grldkln/WCR/WRC Iso Image.jpg

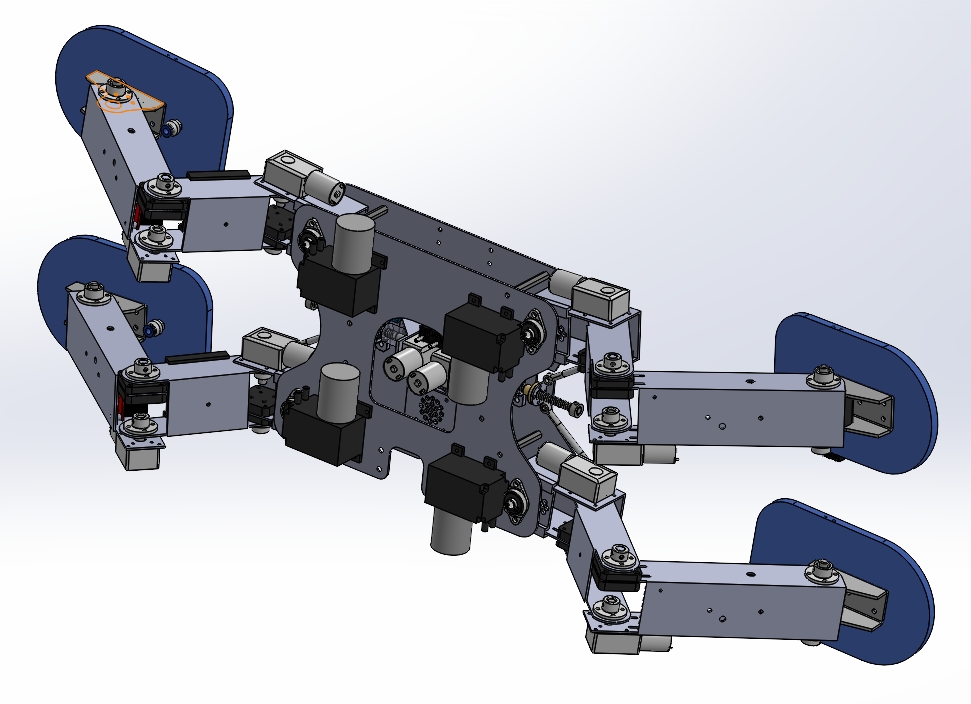
WRC Iso Image.jpg
