grldkln/WCR/WRC Front View.jpg

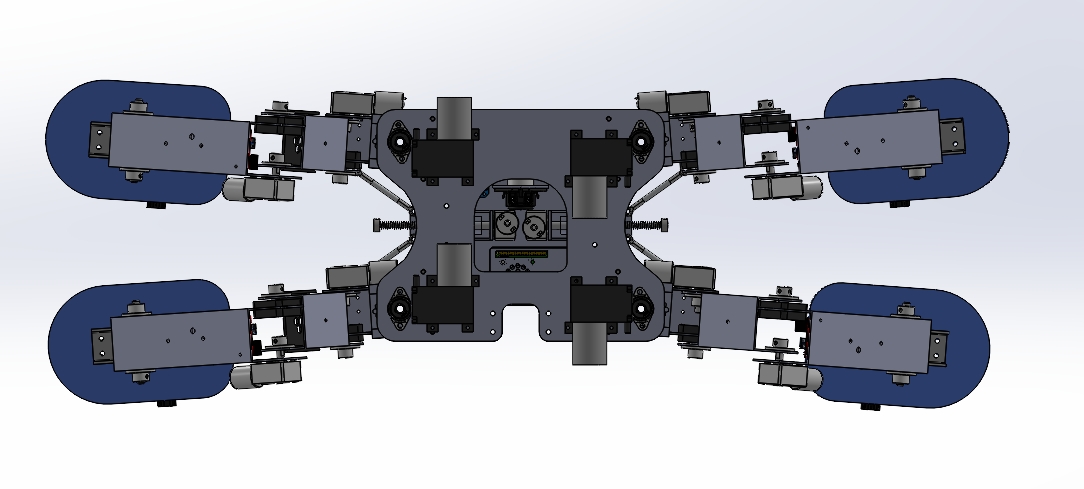
WRC Front View.jpg
