grldkln/WCR/README.md

Please note that this repository is used only as a showcase for my final thesis project.
All of the designs are made by myself, with some code dependencies.
This project is not meant to be developed further, but can be used as a reference or as an example.
