grldkln/WCR/RP4 Mount.jpg

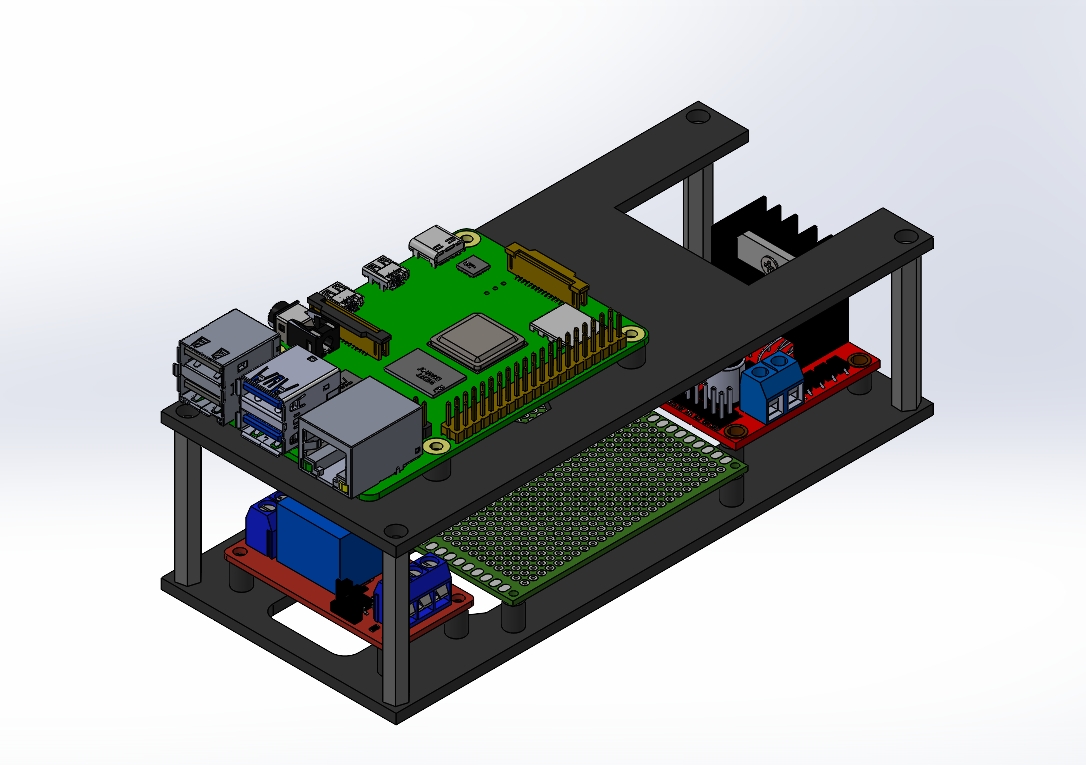
RP4 Mount.jpg
