grldkln/WCR/Controller_Board/Limb Controller Schematic ver 0.1.pdf

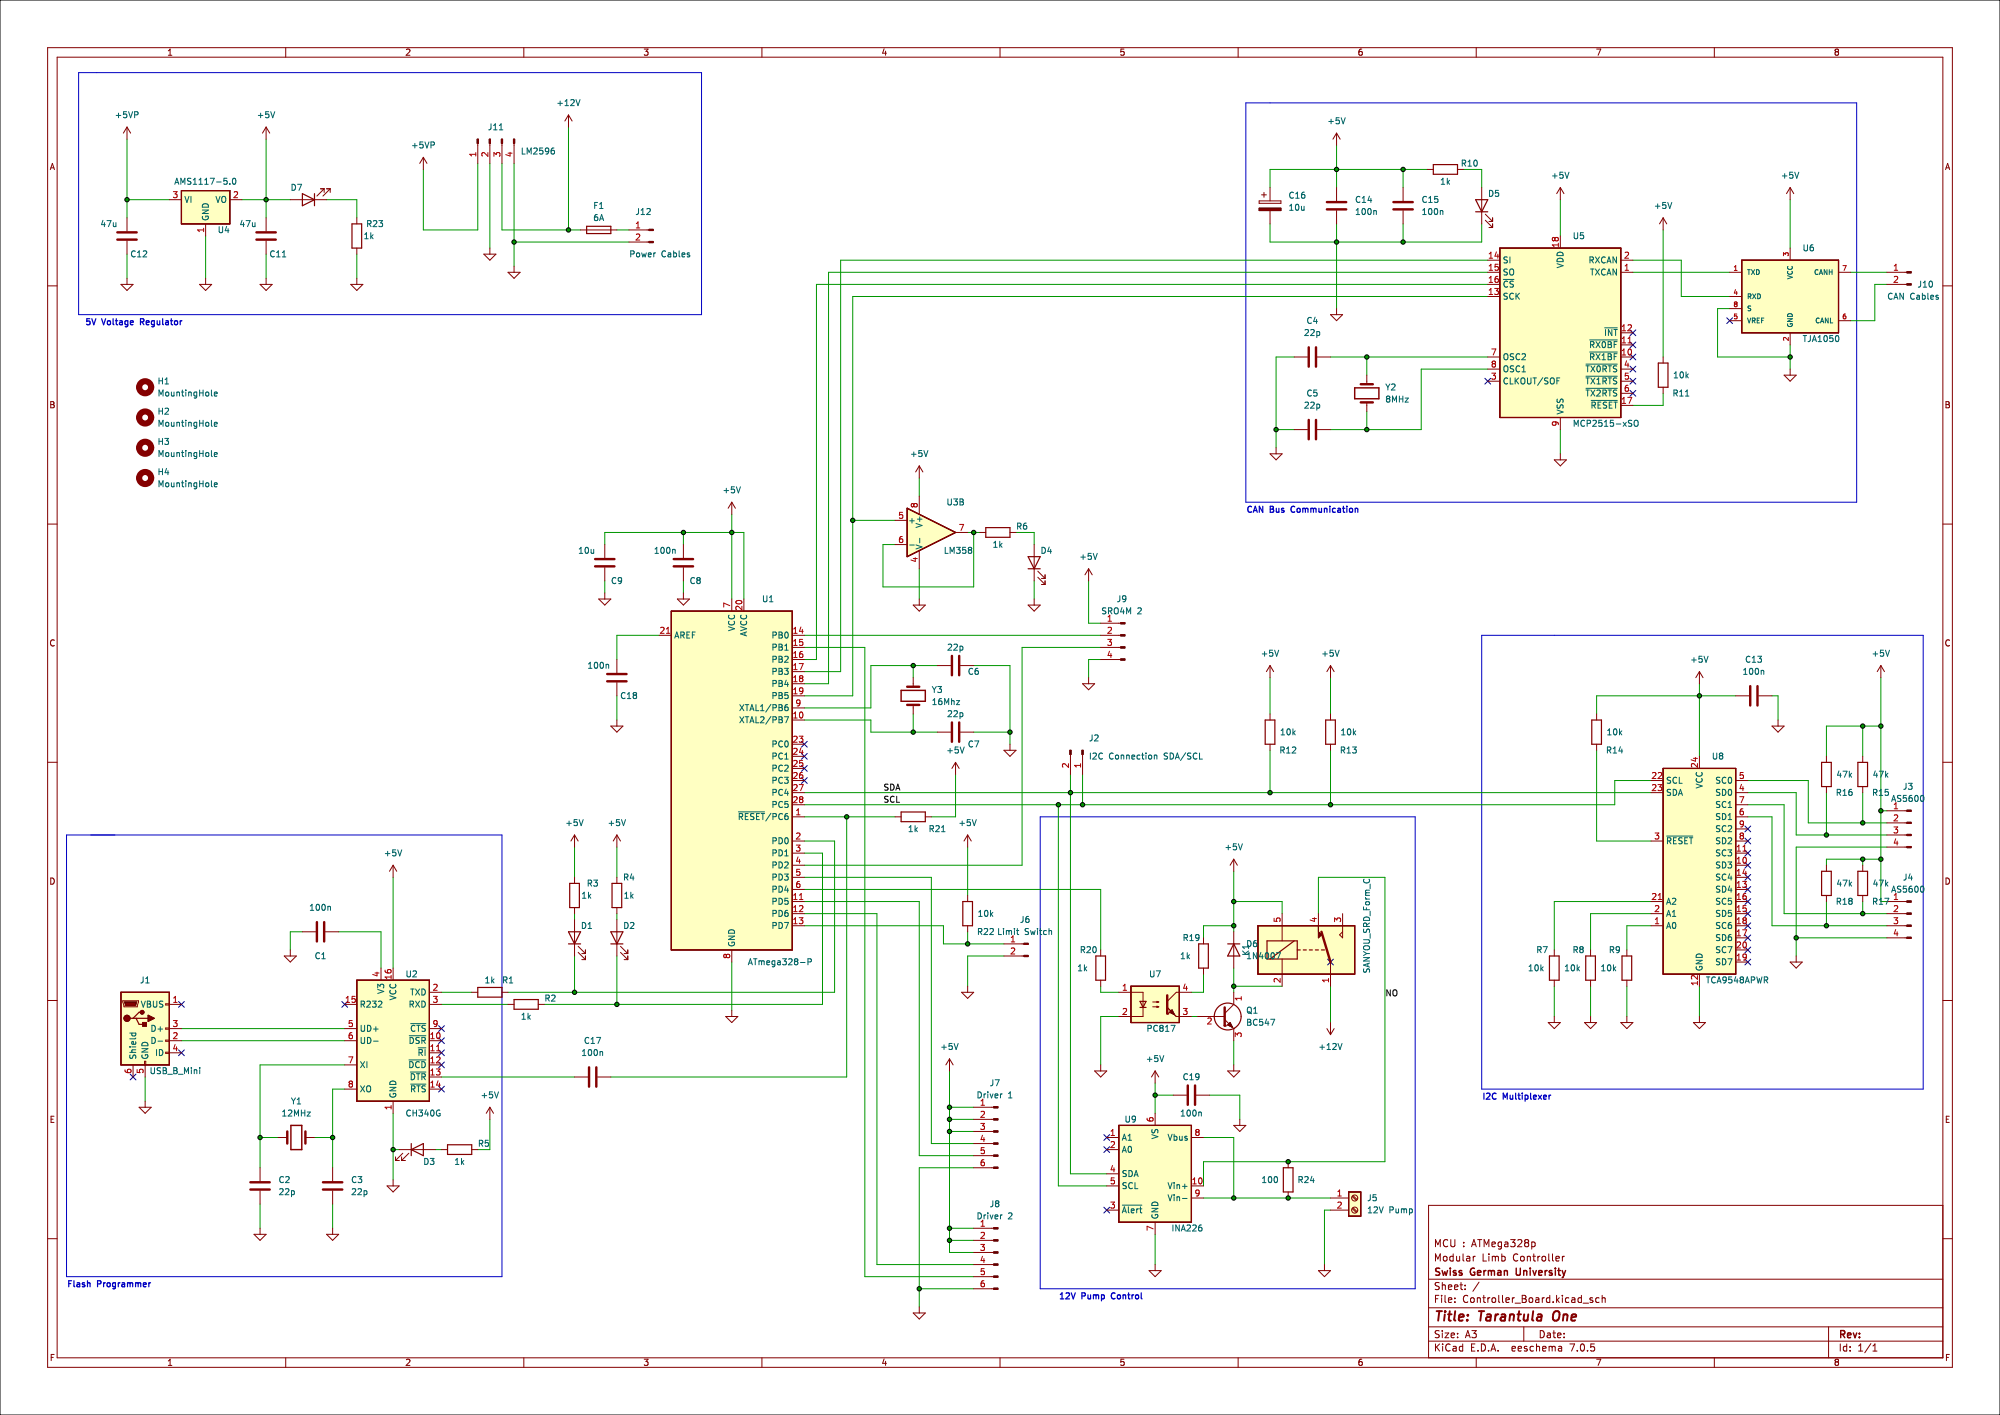
[picture p63: page 1]
