grldkln/WCR/Controller_Board/Controller_Board.kicad_pcb

## KiCad design Controller_Board/Controller_Board.kicad_pcb (2025-01-19)

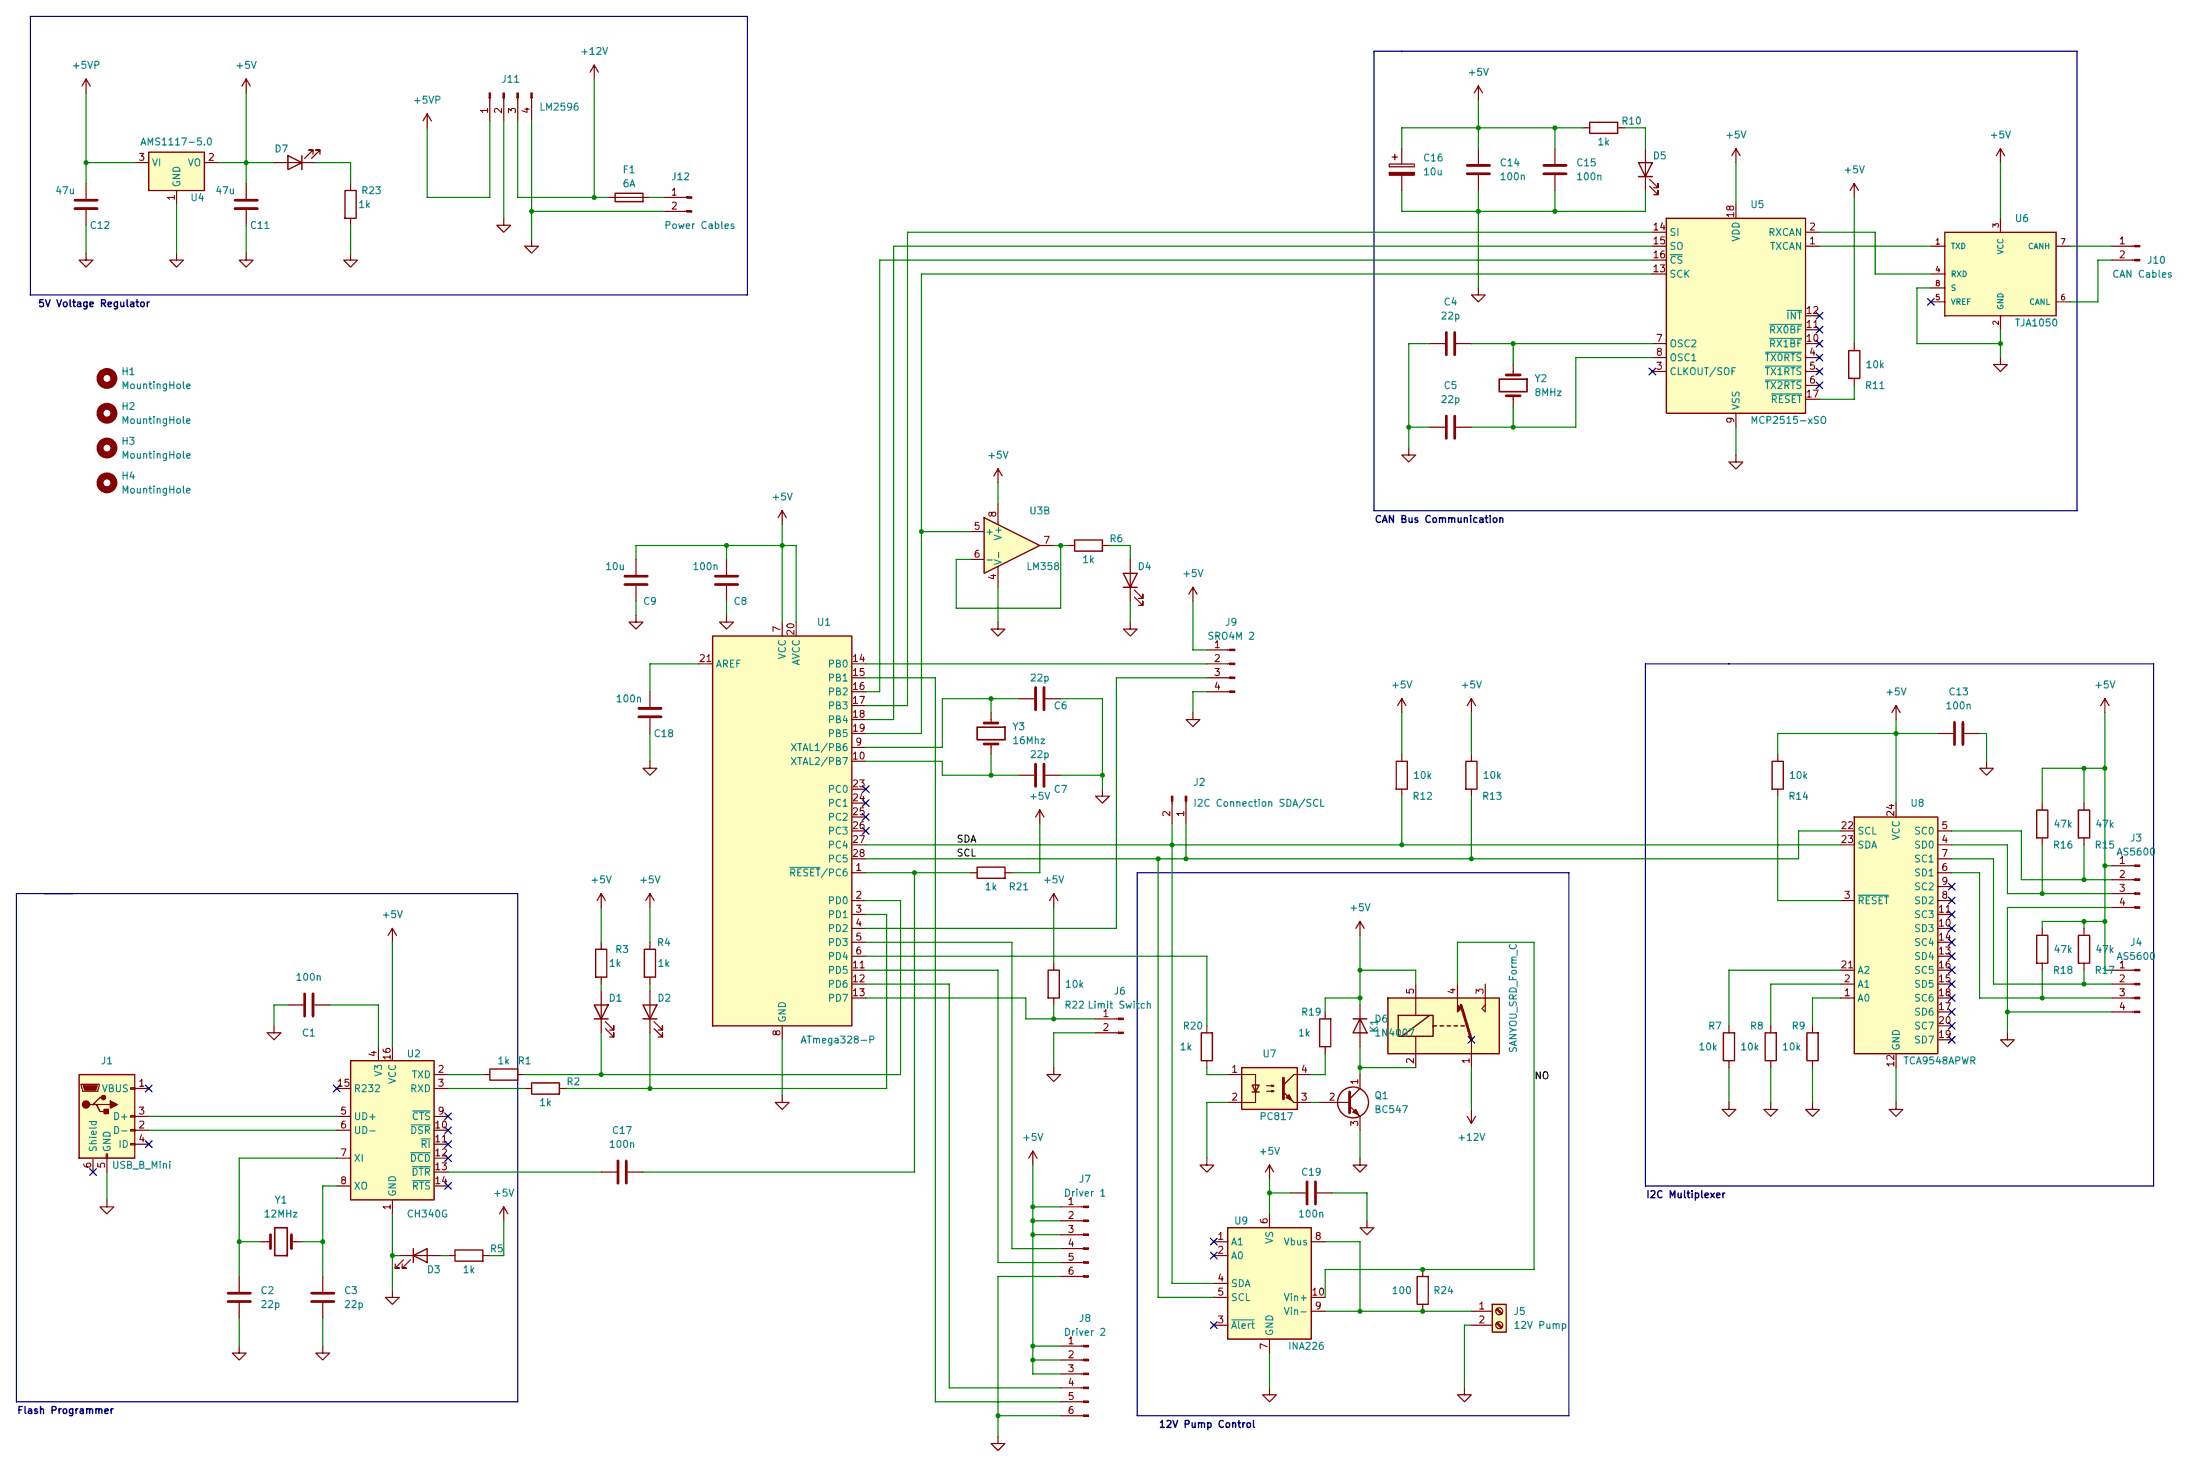
[picture p64: schematic Controller_Board.kicad_sch, Tarantula One]

Parts:
C1, C8, C13, C14, C15, C17, C18, C19: 100n; C_0805_2012Metric
C2, C3, C4, C5, C6, C7: 22p; C_0603_1608Metric
C9: 10u; C_0805_2012Metric
C11, C12: 47u; CP_Elec_8x10
C16: 10u; C_1206_3216Metric
D1, D2, D3, D4, D5, D7: LED; LED_0603_1608Metric
D6: 1N4007; D_DO-41_SOD81_P10.16mm_Horizontal
F1: 6A; Fuse_1206_3216Metric
H1, H2, H3, H4: MountingHole; MountingHole_3mm
J1: USB_B_Mini; USB_Mini-B_Lumberg_2486_01_Horizontal
J2: I2C Connection SDA/SCL; PinHeader_1x02_P2.54mm_Vertical
J3, J4: AS5600; JST_PH_B4B-PH-K_1x04_P2.00mm_Vertical
J5: 12V Pump; TerminalBlock_TE_282834-2_1x02_P2.54mm_Horizontal
J6: Limit Switch; JST_PH_B2B-PH-K_1x02_P2.00mm_Vertical
J7: Driver 1; JST_PH_B6B-PH-K_1x06_P2.00mm_Vertical
J8: Driver 2; JST_PH_B6B-PH-K_1x06_P2.00mm_Vertical
J9: SRO4M 2; JST_PH_B4B-PH-K_1x04_P2.00mm_Vertical
J10: CAN Cables; Pad_2X
J11: LM2596; TerminalBlock_TE_282834-4_1x04_P2.54mm_Horizontal
J12: Power Cables; Pad_2X
K1: SANYOU_SRD_Form_C; Relay_SPDT_SANYOU_SRD_Series_Form_C
Q1: BC547; TSOT-23
R1, R2, R3, R4, R5, R6, R10, R19, R20, R21, R23: 1k; R_0805_2012Metric
R7, R8, R9, R11, R12, R13, R14, R22: 10k; R_0805_2012Metric
R15, R16, R17, R18: 47k; R_0805_2012Metric
R24: 100; R_2512_6332Metric
U1: ATmega328-P; DIP-28_W7.62mm
U2: CH340G; SOIC-16_3.9x9.9mm_P1.27mm
U3: LM358; SOIC-8_3.9x4.9mm_P1.27mm
U4: AMS1117-5.0; SOT-223-3_TabPin2
U5: MCP2515-xSO; SOIC-18W_7.5x11.6mm_P1.27mm
U6: TJA1050; SOT96-1
U7: PC817; DIP-4_W7.62mm
U8: TCA9548APWR; TSSOP-24_4.4x7.8mm_P0.65mm
U9: INA226; VSSOP-10_3x3mm_P0.5mm
Y1: 12MHz; Crystal_HC49-U_Vertical
Y2: 8MHz; Crystal_HC49-U_Vertical
Y3: 16Mhz; Crystal_HC49-U_Vertical

Connections:
+5V: C8.2, C9.2, C11.2, C13.1, C14.1, C15.1, C16.1, C19.1, D6.1 (K), D7.2 (A), J3.1, J4.1, J7.1, J7.2, J7.3, J8.1, J8.2, J8.3, J9.1, K1.5, R3.1, R4.1, R5.2, R10.1, R11.1, R12.1, R13.1, R14.1, R15.1, R16.1, R17.1, R18.1, R19.2, R21.2, R22.1, U1.7 (VCC), U1.20 (AVCC), U2.16 (VCC), U3.8 (V+), U4.2 (VO), U5.18 (VDD), U6.3 (VCC), U8.24 (VCC), U9.6 (VS)
+5VP: C12.2, J11.1, U4.3 (VI)
+12V: F1.1, J11.3, K1.1
/NO: K1.4, R24.2, U9.10 (Vin+)
/SCL: J2.1, R13.2, U1.28 (PC5), U8.22 (SCL), U9.5 (SCL)
/SDA: J2.2, R12.2, U1.27 (PC4), U8.23 (SDA), U9.4 (SDA)
GND: C1.1, C2.2, C3.2, C4.2, C5.2, C6.1, C7.1, C8.1, C9.1, C11.1, C12.1, C13.2, C14.2, C15.2, C16.2, C18.1, C19.2, D3.1 (K), D4.1 (K), D5.1 (K), J1.5 (GND), J3.4, J4.4, J5.2, J6.2, J7.6, J8.6, J9.4, J11.2, J11.4, J12.2, Q1.3 (E), R7.1, R8.1, R9.1, R23.2, U1.8 (GND), U1.22 (GND), U2.1 (GND), U3.4 (V-), U4.1 (GND), U5.9 (VSS), U6.2 (GND), U6.8 (S), U7.2, U8.12 (GND), U9.7 (GND)
unnamed: D1.2 (A), R3.2
unnamed: D1.1 (K), R1.2, U1.2 (PD0)
unnamed: D2.2 (A), R4.2
unnamed: D2.1 (K), R2.2, U1.3 (PD1)
unnamed: D3.2 (A), R5.1
unnamed: D4.2 (A), R6.2
unnamed: D5.2 (A), R10.2
unnamed: D6.2 (A), K1.2, Q1.1 (C)
unnamed: D7.1 (K), R23.1
unnamed: J1.3 (D+), U2.5 (UD+)
unnamed: J1.2 (D-), U2.6 (UD-)
unnamed: J3.2, R15.2, U8.5 (SC0)
unnamed: J3.3, R16.2, U8.4 (SD0)
unnamed: J4.2, R17.2, U8.7 (SC1)
unnamed: J4.3, R18.2, U8.6 (SD1)
unnamed: J5.1, R24.1, U9.8 (Vbus), U9.9 (Vin-)
unnamed: J6.1, R22.2, U1.13 (PD7)
unnamed: J7.4, U1.5 (PD3)
unnamed: J7.5, U1.11 (PD5)
unnamed: J8.4, U1.12 (PD6)
unnamed: J8.5, U1.15 (PB1)
unnamed: J9.2, U1.14 (PB0)
unnamed: J9.3, U1.4 (PD2)
unnamed: J10.1, U6.7 (CANH)
unnamed: J10.2, U6.6 (CANL)
unnamed: F1.2, J12.1
unnamed: Q1.2 (B), U7.3
unnamed: R19.1, U7.4
unnamed: R20.1, U7.1
unnamed: C18.2, U1.21 (AREF)
unnamed: U1.16 (PB2), U5.16 (~CS)
unnamed: U1.17 (PB3), U5.14 (SI)
unnamed: U1.18 (PB4), U5.15 (SO)
unnamed: U1.19 (PB5), U3.5 (+), U5.13 (SCK)
unnamed: R20.2, U1.6 (PD4)
unnamed: C6.2, U1.9 (XTAL1/PB6), Y3.1
unnamed: C7.2, U1.10 (XTAL2/PB7), Y3.2
unnamed: C17.2, R21.1, U1.1 (~RESET/PC6)
unnamed: R2.1, U2.3 (RXD)
unnamed: R1.1, U2.2 (TXD)
unnamed: C1.2, U2.4 (V3)
unnamed: C2.1, U2.7 (XI), Y1.2
unnamed: C3.1, U2.8 (XO), Y1.1
unnamed: C17.1, U2.13 (~DTR)
unnamed: R6.1, U3.6 (-), U3.7
unnamed: C5.1, U5.8 (OSC1), Y2.2
unnamed: C4.1, U5.7 (OSC2), Y2.1
unnamed: U5.2 (RXCAN), U6.4 (RXD)
unnamed: U5.1 (TXCAN), U6.1 (TXD)
unnamed: R11.2, U5.17 (~RESET)
unnamed: R9.2, U8.1 (A0)
unnamed: R8.2, U8.2 (A1)
unnamed: R7.2, U8.21 (A2)
unnamed: R14.2, U8.3 (~RESET)

Notes on the sheet:
I2C Multiplexer
12V Pump Control
5V Voltage Regulator
CAN Bus Communication
Flash Programmer

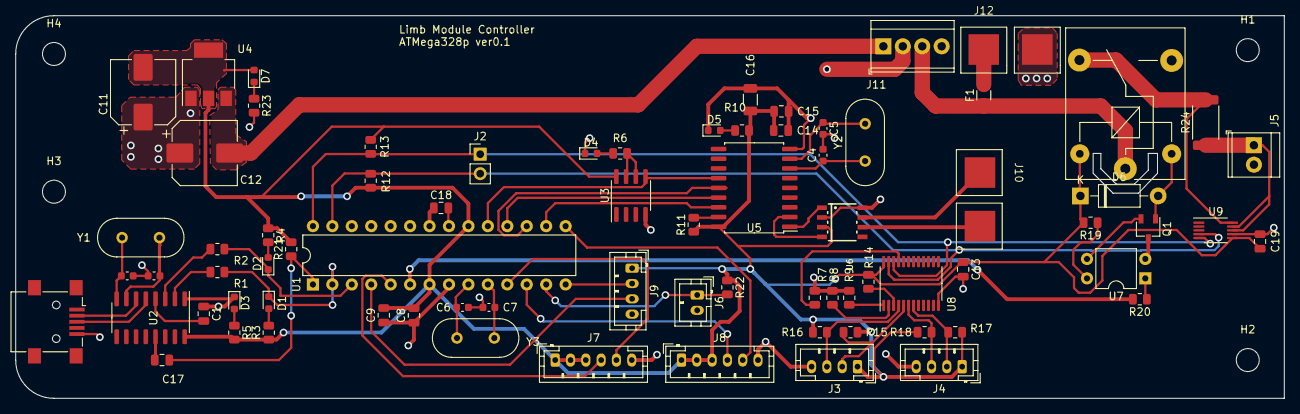
[picture p65: board Controller_Board.kicad_pcb from above]

Board: 2 copper layers, 165.8 x 50.0 mm, 80 parts (0 on the bottom side), 61 nets.
